kvanderlaag/shame-master/README.md

# shame-master
A depressing clone of the Creative Labs CT-1300B Game Blaster

TODO:
- Explain what the shit this stupid thing does
- Explain all the ways in which it is bad
- Explain the differences from the original Game Blaster
- Add a bill of materials
