kvanderlaag/shame-master/shamemaster.pdf

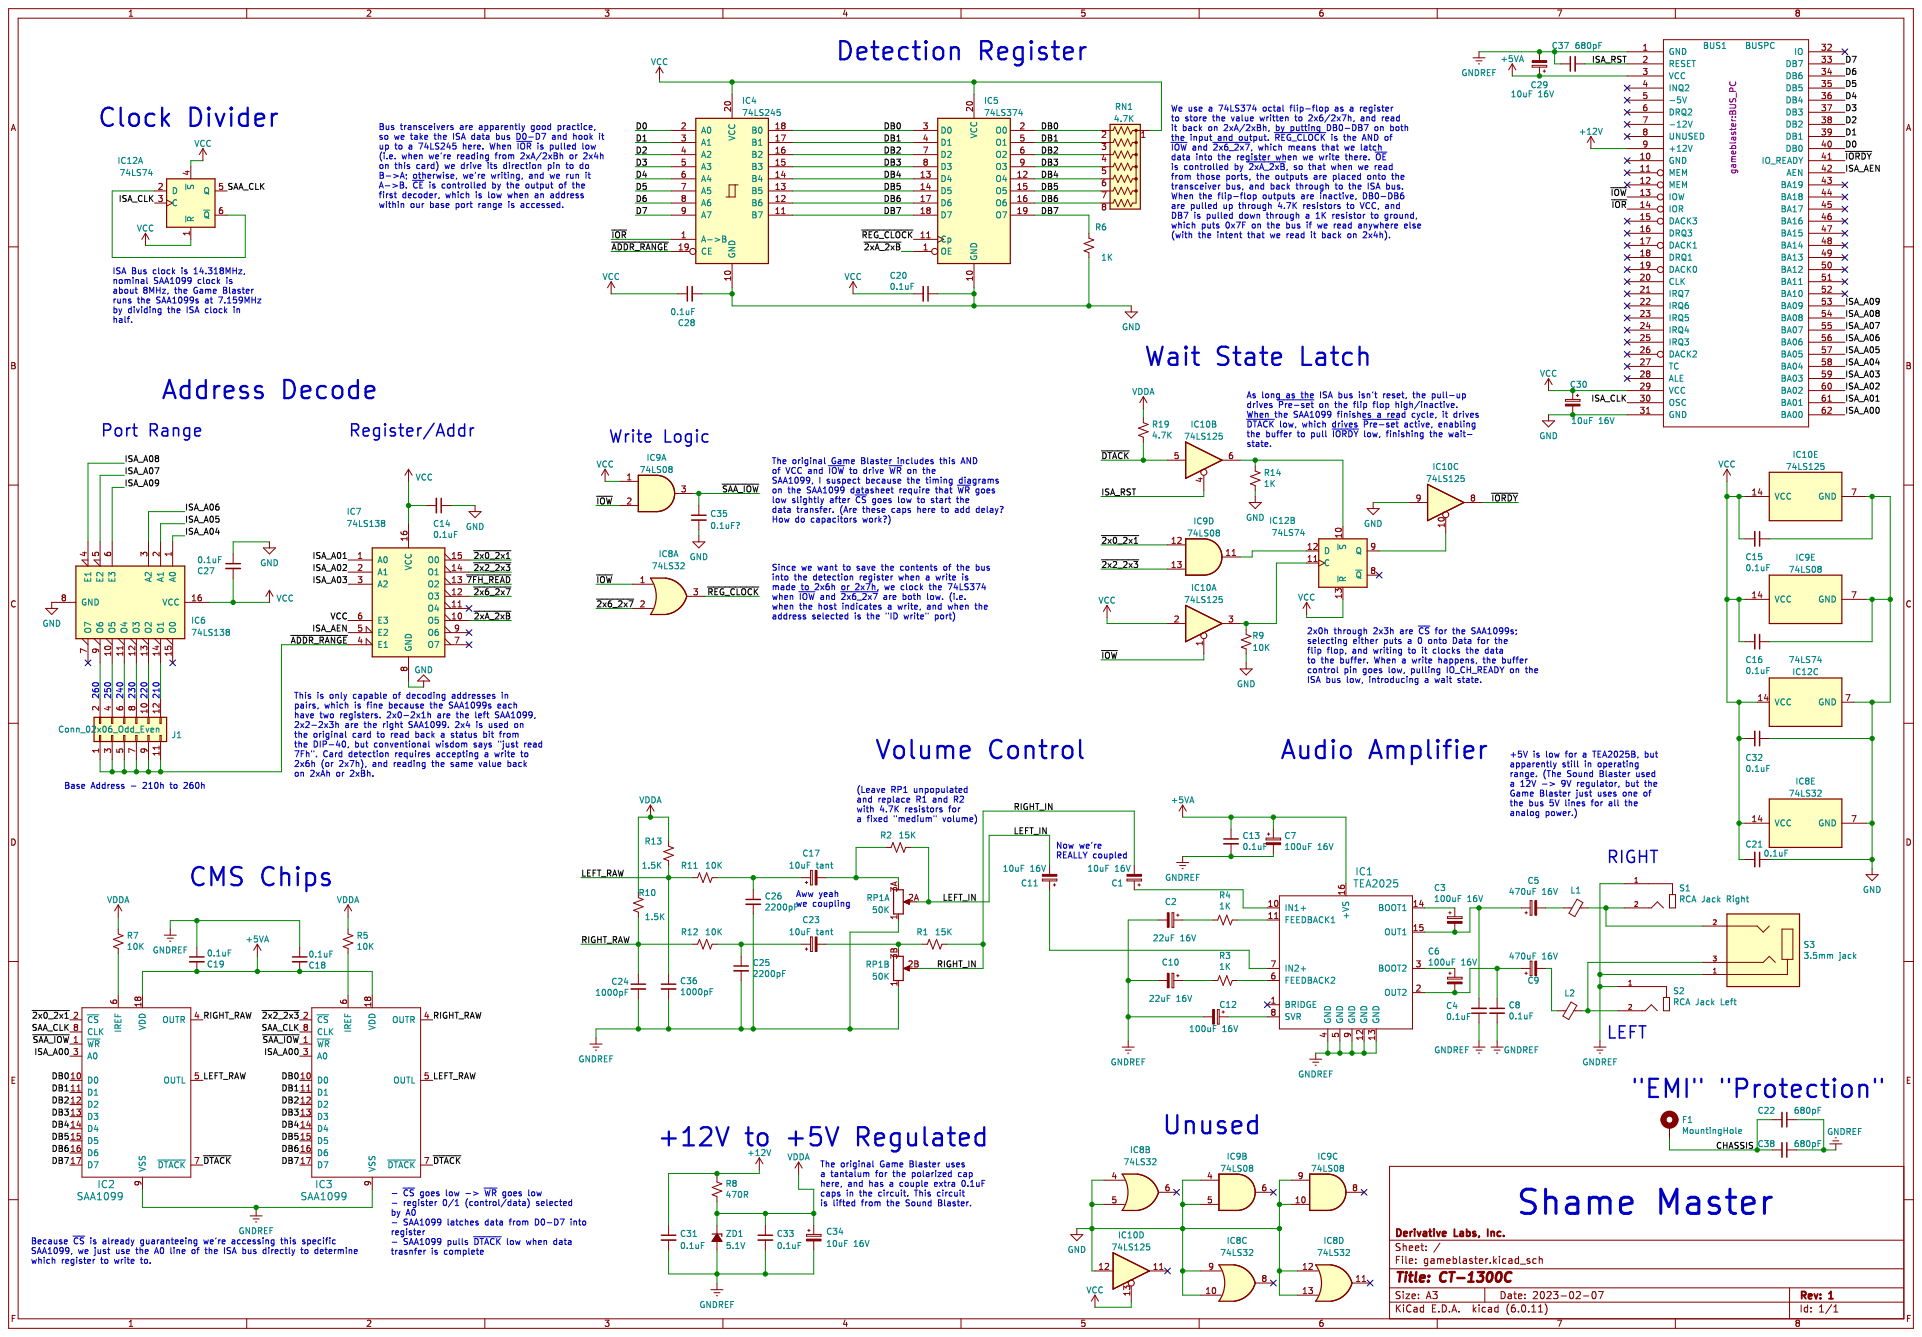
[picture p1: page 1]
