kvanderlaag/shame-master/gameblaster.kicad_pcb

## KiCad design gameblaster.kicad_pcb (2023-03-15)

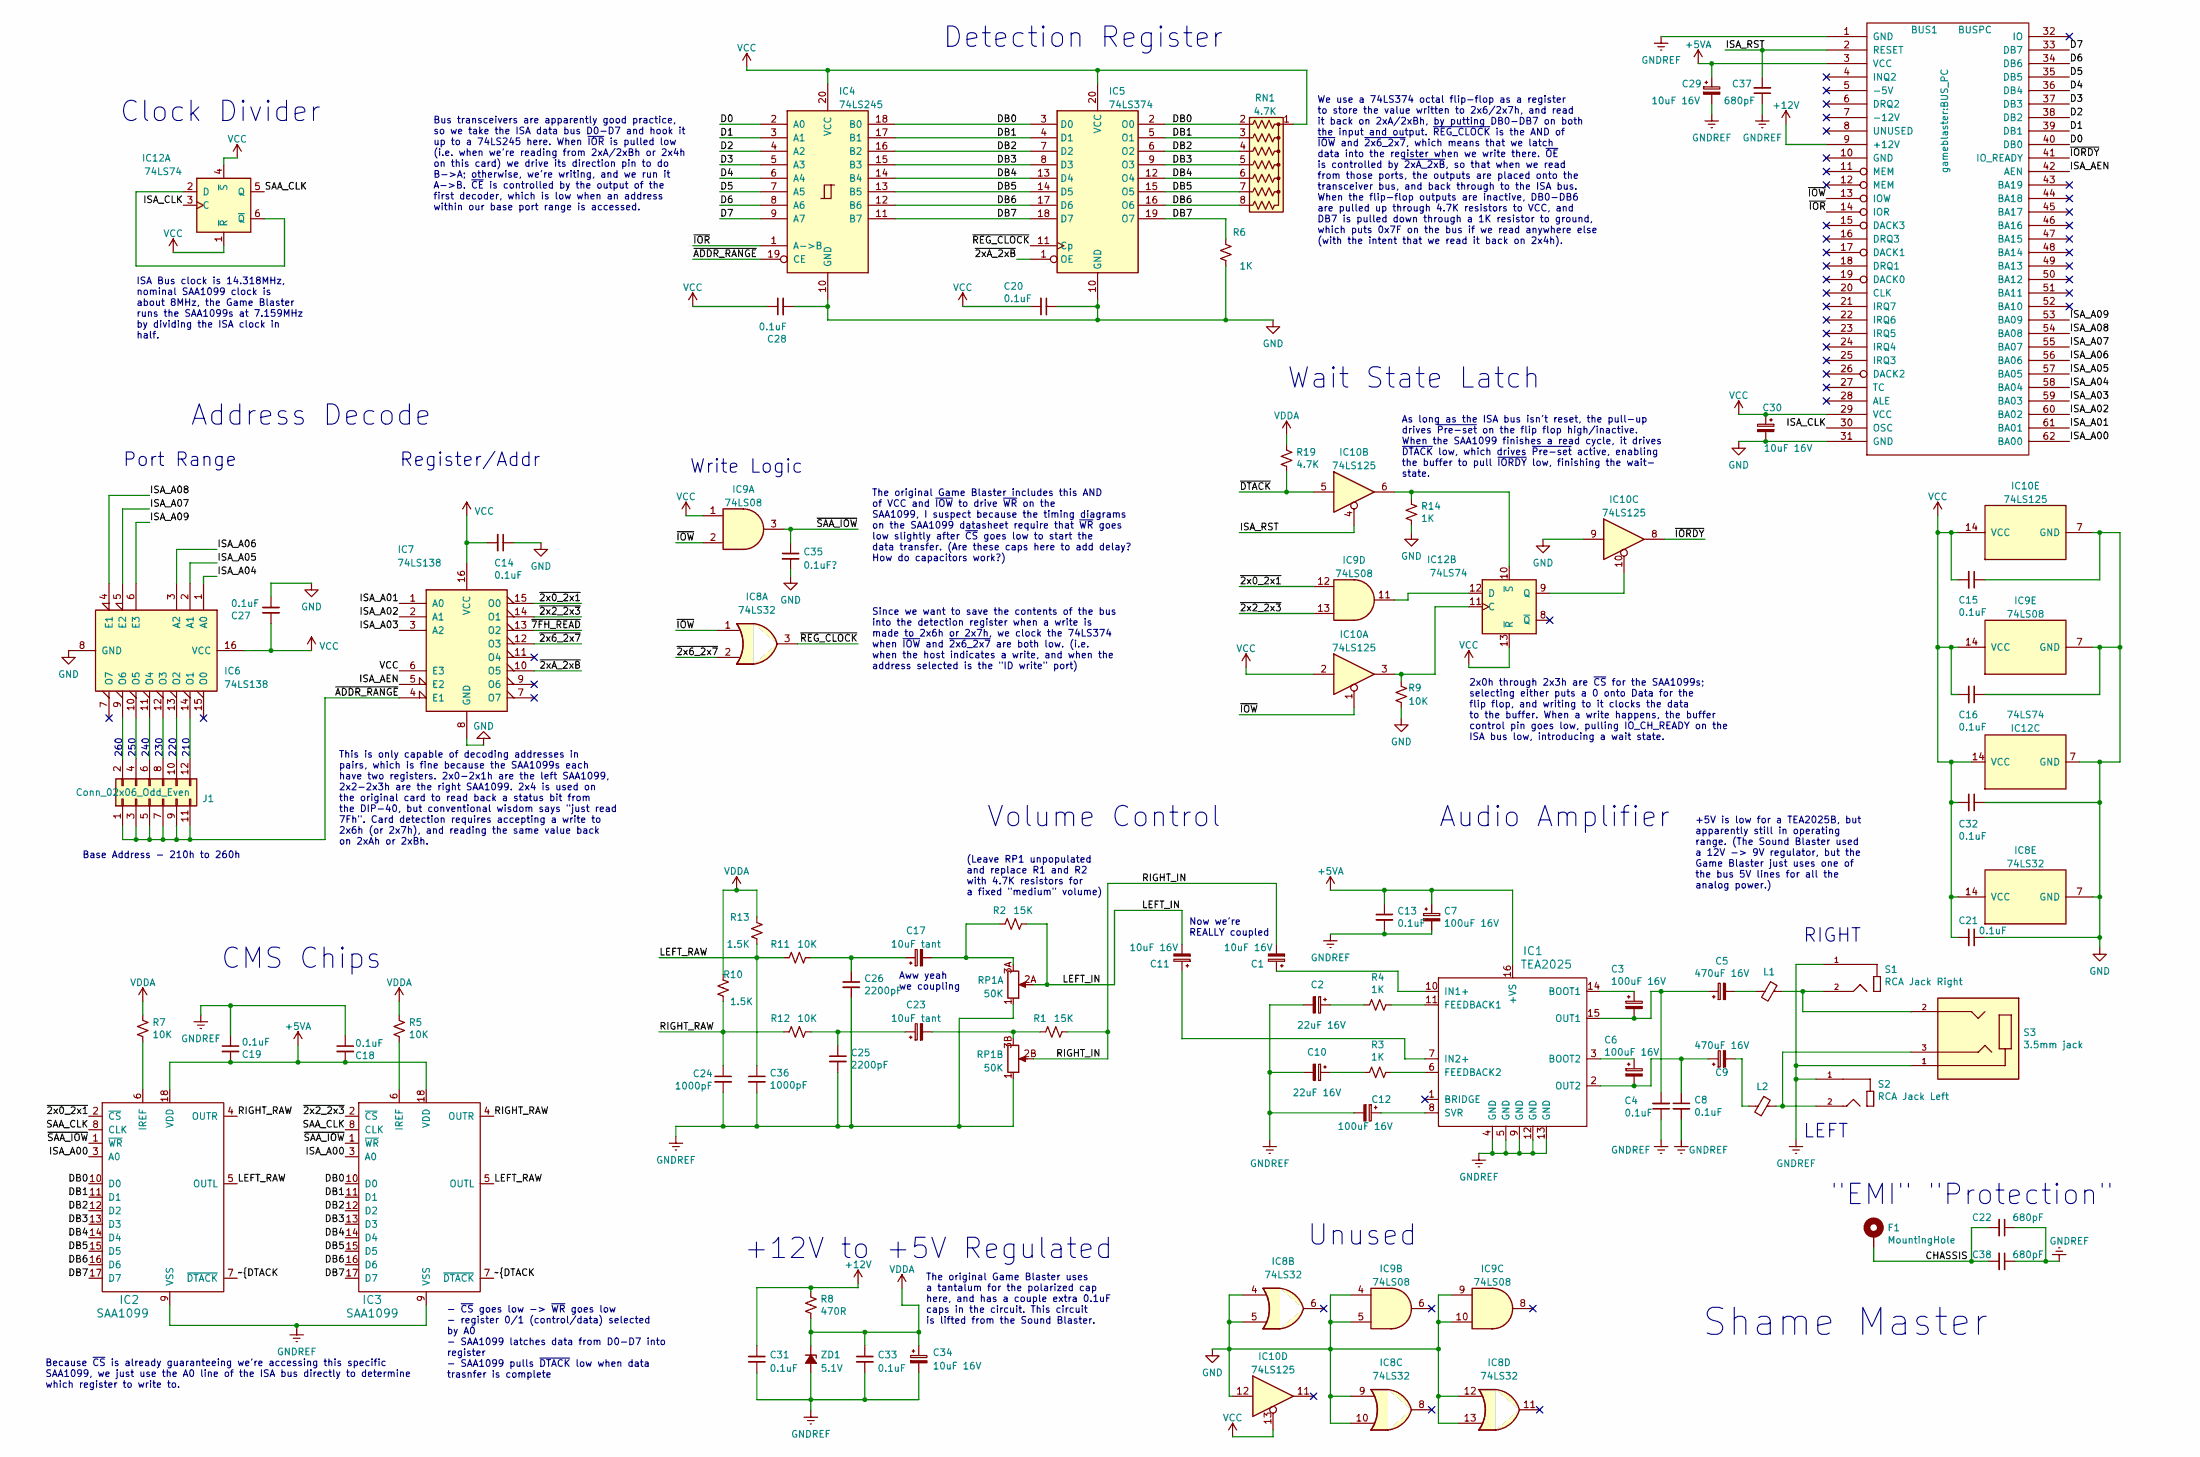
[picture p2: schematic gameblaster.kicad_sch, CT-1300C]

Parts:
BUS1: BUSPC; BUS_PC
C1, C11, C29, C30, C34: 10uF 16V; CAPAP100
C2, C10: 22uF 16V; CAPAP100
C3, C6, C7, C12: 100uF 16V; CAPAP200
C4, C8, C13, C14, C15, C16, C18, C19, C20, C21, C27, C28, C31, C32, C33: 0.1uF; CAPAC200
C5, C9: 470uF 16V; CAPAP200
C17, C23: 10uF tant; CAPAP100; DigiKey 478-11561-1-ND
C22, C37, C38: 680pF; CAPAC200
C24, C36: 1000pF; CAPAC200
C25, C26: 2200pF; CAPAC200
C35: 0.1uF?; CAPAC200
F1: MountingHole; MNT_KEYSTONE_9202
IC1: TEA2025; DIP254P762X635-16
IC2, IC3: SAA1099; DIP254P762X635-18
IC4: 74LS245; DIP254P762X635-20
IC5: 74LS374; DIP254P762X635-20
IC6, IC7: 74LS138; DIP254P762X635-16
IC8: 74LS32; DIP254P762X635-14
IC9: 74LS08; DIP254P762X635-14
IC10: 74LS125; DIP254P762X635-14
IC12: 74LS74; DIP254P762X635-14
J1: Conn_02x06_Odd_Even; SB_HDR_2X6
L1, L2: Ferrite_Bead_Small; INDA500P780X750
R1, R2: 15K; RESA400
R3, R4, R6, R14: 1K; RESA400
R5, R7, R9, R11, R12: 10K; RESA400
R8: 470R; RESA400
R10, R13: 1.5K; RESA400
R19: 4.7K; RESA400
RN1: 4.7K; R_Array_SIP8
RP1: 50K; GB_BOURNS_PDB08-DUAL
S1: RCA Jack Right; CUI_RCJ-042
S2: RCA Jack Left; CUI_RCJ-043
S3: 3.5mm jack; CUI_SJ1-3553NG
ZD1: 5.1V; DIOA400

Connections:
+5VA: BUS1.3 (VCC), C7.1, C13.1, C18.2, C19.2, C29.1, IC1.16 (+VS), IC2.18 (VDD), IC3.18 (VDD)
+12V: BUS1.9 (+12V), C31.1, R8.1
/CHASSIS: C22.2, C38.2, F1.1
/D0: BUS1.40 (DB0), IC4.2 (A0)
/D1: BUS1.39 (DB1), IC4.3 (A1)
/D2: BUS1.38 (DB2), IC4.4 (A2)
/D3: BUS1.37 (DB3), IC4.5 (A3)
/D4: BUS1.36 (DB4), IC4.6 (A4)
/D5: BUS1.35 (DB5), IC4.7 (A5)
/D6: BUS1.34 (DB6), IC4.8 (A6)
/D7: BUS1.33 (DB7), IC4.9 (A7)
/DB0: IC2.10 (D0), IC3.10 (D0), IC4.18 (B0), IC5.2 (O0), IC5.3 (D0), RN1.2 (R1)
/DB1: IC2.11 (D1), IC3.11 (D1), IC4.17 (B1), IC5.4 (D1), IC5.5 (O1), RN1.3 (R2)
/DB2: IC2.12 (D2), IC3.12 (D2), IC4.16 (B2), IC5.6 (O2), IC5.7 (D2), RN1.4 (R3)
/DB3: IC2.13 (D3), IC3.13 (D3), IC4.15 (B3), IC5.8 (D3), IC5.9 (O3), RN1.5 (R4)
/DB4: IC2.14 (D4), IC3.14 (D4), IC4.14 (B4), IC5.12 (O4), IC5.13 (D4), RN1.6 (R5)
/DB5: IC2.15 (D5), IC3.15 (D5), IC4.13 (B5), IC5.14 (D5), IC5.15 (O5), RN1.7 (R6)
/DB6: IC2.16 (D6), IC3.16 (D6), IC4.12 (B6), IC5.16 (O6), IC5.17 (D6), RN1.8 (R7)
/DB7: IC2.17 (D7), IC3.17 (D7), IC4.11 (B7), IC5.18 (D7), IC5.19 (O7), R6.1
/ISA_A00: BUS1.62 (BA00), IC2.3 (A0), IC3.3 (A0)
/ISA_A01: BUS1.61 (BA01), IC7.1 (A0)
/ISA_A02: BUS1.60 (BA02), IC7.2 (A1)
/ISA_A03: BUS1.59 (BA03), IC7.3 (A2)
/ISA_A04: BUS1.58 (BA04), IC6.1 (A0)
/ISA_A05: BUS1.57 (BA05), IC6.2 (A1)
/ISA_A06: BUS1.56 (BA06), IC6.3 (A2)
/ISA_A07: BUS1.55 (BA07), IC6.5 (E2)
/ISA_A08: BUS1.54 (BA08), IC6.4 (E1)
/ISA_A09: BUS1.53 (BA09), IC6.6 (E3)
/ISA_AEN: BUS1.42 (AEN), IC7.5 (E2)
/ISA_CLK: BUS1.30 (OSC), IC12.3 (C)
/ISA_RST: BUS1.2 (RESET), C37.2, IC10.4
/LEFT_IN: C11.2, R2.2, RP1.2A
/LEFT_RAW: C36.1, IC2.5 (OUTL), IC3.5 (OUTL), R11.1, R13.1
/RIGHT_IN: C1.2, R1.2, RP1.2B
/RIGHT_RAW: C24.1, IC2.4 (OUTR), IC3.4 (OUTR), R10.1, R12.1
/SAA_CLK: IC2.8 (CLK), IC3.8 (CLK), IC12.5 (Q)
/~2x0_2x1: IC2.2 (~CS), IC7.15 (O0), IC9.12
/~2x2_2x3: IC3.2 (~CS), IC7.14 (O1), IC9.13
/~2x6_2x7: IC7.12 (O3), IC8.2
/~2xA_2xB: IC5.1 (OE), IC7.10 (O5)
/~7FH_READ: IC7.13 (O2)
/~ADDR_RANGE: IC4.19 (CE), IC7.4 (E1), J1.1, J1.3, J1.5, J1.7, J1.9, J1.11
/~IORDY: BUS1.41 (IO_READY), IC10.8
/~IOR: BUS1.14 (IOR), IC4.1 (A->B)
/~IOW: BUS1.13 (IOW), IC8.1, IC9.2, IC10.1
/~REG_CLOCK: IC5.11 (Cp), IC8.3
/~SAA_IOW: C35.1, IC2.1 (~WR), IC3.1 (~WR), IC9.3
GND: BUS1.31 (GND), C14.1, C15.1, C16.1, C20.1, C21.1, C27.1, C28.2, C30.2, C32.1, C35.2, IC4.10 (GND), IC5.10 (GND), IC6.8 (GND), IC7.8 (GND), IC8.4, IC8.5, IC8.7 (GND), IC8.9, IC8.10, IC8.12, IC8.13, IC9.4, IC9.5, IC9.7 (GND), IC9.9, IC9.10, IC10.7 (GND), IC10.9, IC10.12, IC12.7 (GND), R6.2, R9.2, R14.2
GNDREF: BUS1.1 (GND), C2.2, C4.1, C7.2, C8.2, C10.2, C12.2, C13.2, C18.1, C19.1, C22.1, C24.2, C25.2, C26.2, C29.2, C31.2, C33.2, C34.2, C36.2, C37.1, C38.1, IC1.4 (GND), IC1.5 (GND), IC1.9 (GND), IC1.12 (GND), IC1.13 (GND), IC2.9 (VSS), IC3.9 (VSS), RP1.1, S1.1, S2.1, S3.1, ZD1.2 (A)
unnamed: C1.1, IC1.10 (IN1+)
unnamed: C2.1, R4.2
unnamed: C3.1, IC1.14 (BOOT1)
unnamed: C3.2, C4.2, C5.1, IC1.15 (OUT1)
unnamed: C5.2, L1.2
unnamed: C6.1, IC1.3 (BOOT2)
unnamed: C6.2, C8.1, C9.1, IC1.2 (OUT2)
unnamed: C9.2, L2.2
unnamed: C10.1, R3.2
unnamed: C11.1, IC1.7 (IN2+)
unnamed: C12.1, IC1.8 (SVR)
unnamed: C17.1, C26.1, R11.2
unnamed: C17.2, R2.1, RP1.3A
unnamed: C23.1, C25.1, R12.2
unnamed: C23.2, R1.1, RP1.3B
unnamed: IC1.6 (FEEDBACK2), R3.1
unnamed: IC1.11 (FEEDBACK1), R4.1
unnamed: IC2.6 (IREF), R7.2
unnamed: IC3.6 (IREF), R5.2
unnamed: IC6.9 (O6), J1.2
unnamed: IC6.10 (O5), J1.4
unnamed: IC6.11 (O4), J1.6
unnamed: IC6.12 (O3), J1.8
unnamed: IC6.13 (O2), J1.10
unnamed: IC6.14 (O1), J1.12
unnamed: IC10.3, IC12.11 (C), R9.1
unnamed: IC10.6, IC12.10 (~S), R14.1
unnamed: IC10.10, IC12.9 (Q)
unnamed: IC12.2 (D), IC12.6 (~Q)
unnamed: IC9.11, IC12.12 (D)
unnamed: L1.1, S1.2, S3.2
unnamed: L2.1, S2.2, S3.3
VCC: BUS1.29 (VCC), C14.2, C15.2, C16.2, C20.2, C21.2, C27.2, C28.1, C30.1, C32.2, IC4.20 (VCC), IC5.20 (VCC), IC6.16 (VCC), IC7.6 (E3), IC7.16 (VCC), IC8.14 (VCC), IC9.1, IC9.14 (VCC), IC10.2, IC10.13, IC10.14 (VCC), IC12.1 (~R), IC12.4 (~S), IC12.13 (~R), IC12.14 (VCC), RN1.1 (common)
VDDA: C33.1, C34.1, R5.1, R7.1, R8.2, R10.2, R13.2, R19.1, ZD1.1 (K)

Notes on the sheet:
Register/Addr
Port Range
Write Logic
+5V is low for a TEA2025B, but apparently still in operating range. (The Sound Blaster used a 12V -> 9V regulator, but the Game Blaster just uses one of the bus 5V lines for all the analog power.)
This is only capable of decoding addresses in pairs, which is fine because the SAA1099s each have two registers. 2x0-2x1h are the left SAA1099, 2x2-2x3h are the right SAA1099. 2x4 is used on the original card to read back a status bit from the DIP-40, but conventional wisdom says "just read 7Fh". C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
ISA Bus clock is 14.318MHz, nominal SAA1099 clock is about 8MHz, the Game Blaster runs the SAA1099s at 7.159MHz by dividing the ISA clock in half.
Wait State Latch
Detection Register
Shame Master
The original Game Blaster uses a tantalum for the polarized cap here, and has a couple extra 0.1uF caps in the circuit. This circuit is lifted from the Sound Blaster.
Bus transceivers are apparently good practice, so we take the ISA data bus D0-D7 and hook it up to a 74LS245 here. When ~{IOR} is pulled low (i.e. when we're reading from 2xA/2xBh or 2x4h on this card) we drive its direction pin to do B->A; otherwise, we're writing, and we run it A->B. ~{CE} is con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
230
"EMI" "Protection"
Volume Control
+12V to +5V Regulated
Since we want to save the contents of the bus into the detection register when a write is made to 2x6h or 2x7h, we clock the 74LS374 when ~{IOW} and ~{2x6_2x7} are both low. (i.e. when the host indicates a write, and when the address selected is the "ID write" port)
Address Decode
Base Address - 210h to 260h
220
We use a 74LS374 octal flip-flop as a register to store the value written to 2x6/2x7h, and read it back on 2xA/2xBh, by putting DB0-DB7 on both the input and output. ~{REG_CLOCK} is the AND of ~{IOW} and ~{2x6_2x7}, which means that we latch data into the register when we write there. ~{OE} is cont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
LEFT
2x0h through 2x3h are ~{CS} for the SAA1099s; selecting either puts a 0 onto Data for the flip flop, and writing to it clocks the data to the buffer. When a write happens, the buffer control pin goes low, pulling IO_CH_READY on the ISA bus low, introducing a wait state.
RIGHT
210
250
Because ~{CS} is already guaranteeing we're accessing this specific SAA1099, we just use the A0 line of the ISA bus directly to determine which register to write to.
240
(Leave RP1 unpopulated and replace R1 and R2 with 4.7K resistors for a fixed "medium" volume)
The original Game Blaster includes this AND of VCC and ~{IOW} to drive ~{WR} on the SAA1099, I suspect because the timing diagrams on the SAA1099 datasheet require that ~{WR} goes low slightly after ~{CS} goes low to start the data transfer. (Are these caps here to add delay? How do capacitors work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
As long as the ISA bus isn't reset, the pull-up drives ~{Pre-set} on the flip flop high/inactive. When the SAA1099 finishes a read cycle, it drives ~{DTACK} low, which drives ~{Pre-set} active, enabling the buffer to pull ~{IORDY} low, finishing the wait- state.
Now we're REALLY coupled
Clock Divider
- ~{CS} goes low -> ~{WR} goes low - register 0/1 (control/data) selected by A0 - SAA1099 latches data from D0-D7 into register - SAA1099 pulls ~{DTACK} low when data trasnfer is complete
CMS Chips
Audio Amplifier
260
Unused
Aww yeah we coupling

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
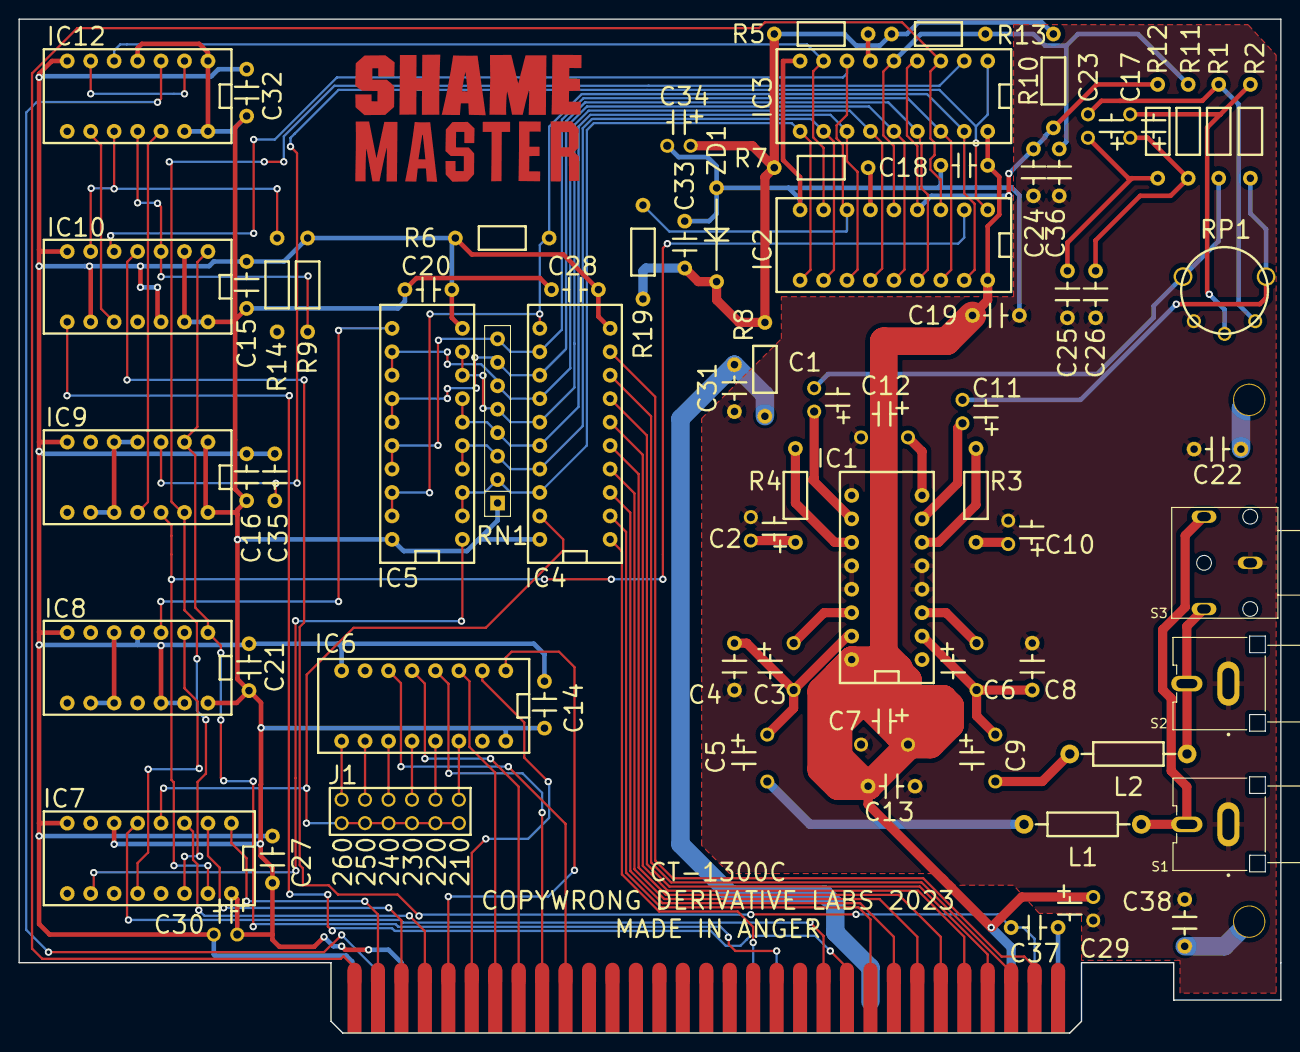
[picture p3: board gameblaster.kicad_pcb from above]

Board: 2 copper layers, 136.7 x 109.8 mm, 75 parts (0 on the bottom side), 84 nets.
