kvanderlaag/shame-master/(commit log)

2023-02-08 rev 0
    who knows if this works? let's find out!
    [gameblaster-B_Cu.gbr, gameblaster-B_Mask.gbr, gameblaster-B_Paste.gbr, gameblaster-B_Silkscreen.gbr, gameblaster-Edge_Cuts.gbr, gameblaster-F_Cu.gbr, gameblaster-F_Mask.gbr, gameblaster-F_Paste.gbr]
2023-02-08 add zener regulator for SAA1099s
    [gameblaster-B_Cu.gbr, gameblaster-B_Mask.gbr, gameblaster-B_Paste.gbr, gameblaster-B_Silkscreen.gbr, gameblaster-Edge_Cuts.gbr, gameblaster-F_Cu.gbr, gameblaster-F_Mask.gbr, gameblaster-F_Paste.gbr]
2023-02-08 moved R6 because i like the way this looks better
    [gameblaster-B_Cu.gbr, gameblaster-B_Mask.gbr, gameblaster-B_Paste.gbr, gameblaster-B_Silkscreen.gbr, gameblaster-Edge_Cuts.gbr, gameblaster-F_Cu.gbr, gameblaster-F_Mask.gbr, gameblaster-F_Paste.gbr]
2023-02-08 added some 3d crap, moved some components around to fit
    [gameblaster-B_Cu.gbr, gameblaster-B_Mask.gbr, gameblaster-B_Paste.gbr, gameblaster-B_Silkscreen.gbr, gameblaster-Edge_Cuts.gbr, gameblaster-F_Cu.gbr, gameblaster-F_Mask.gbr, gameblaster-F_Paste.gbr]
2023-02-08 add logo, engorge zones, clip solder mask from card fingers
    [gameblaster-B_Cu.gbr, gameblaster-B_Mask.gbr, gameblaster-B_Paste.gbr, gameblaster-B_Silkscreen.gbr, gameblaster-Edge_Cuts.gbr, gameblaster-F_Cu.gbr, gameblaster-F_Mask.gbr, gameblaster-F_Paste.gbr]
2023-02-16 so much dumb shit
    [gameblaster-B_Cu.gbr, gameblaster-B_Mask.gbr, gameblaster-B_Paste.gbr, gameblaster-B_Silkscreen.gbr, gameblaster-Edge_Cuts.gbr, gameblaster-F_Cu.gbr, gameblaster-F_Mask.gbr, gameblaster-F_Paste.gbr]
2023-02-16 dumb schematic shit
    [gameblaster.kicad_sch]
2023-02-17 heavily annotate schematic
    [gameblaster.kicad_sch]
2023-02-17 Separate +5VA and VDDA; re-add SAA1099 output current source; use power symbols
    [gameblaster.kicad_pcb, gameblaster.kicad_sch]
2023-02-17 updated board
    yes i know the left ICs are misaligned
    [gameblaster.kicad_pcb, gameblaster.kicad_sch]
2023-02-17 update pdf
    [gameblaster.kicad_sch]
2023-02-17 realign IC7 through IC11
    [gameblaster.kicad_pcb]
2023-02-17 fuck it let's add a big old digital ground plane
    [gameblaster.kicad_pcb]
2023-02-20 update gerbil
    [gameblaster-B_Cu.gbr, gameblaster-B_Mask.gbr, gameblaster-B_Paste.gbr, gameblaster-B_Silkscreen.gbr, gameblaster-Edge_Cuts.gbr, gameblaster-F_Cu.gbr, gameblaster-F_Mask.gbr, gameblaster-F_Paste.gbr]
2023-03-04 Fix some shit
    [gameblaster-B_Cu.gbr, gameblaster-B_Mask.gbr, gameblaster-B_Paste.gbr, gameblaster-B_Silkscreen.gbr, gameblaster-Edge_Cuts.gbr, gameblaster-F_Cu.gbr, gameblaster-F_Mask.gbr, gameblaster-F_Paste.gbr]
2023-03-15 Add 3D models for Bracket and Volume pot/knob, update gerbers
    [gameblaster-B_Cu.gbr, gameblaster-B_Mask.gbr, gameblaster-B_Paste.gbr, gameblaster-B_Silkscreen.gbr, gameblaster-Edge_Cuts.gbr, gameblaster-F_Cu.gbr, gameblaster-F_Mask.gbr, gameblaster-F_Paste.gbr]
